LiamxZhang/CuBoats_Project/Arduino/Servo_Propeller_controller/readme.txt

1. 命令分类：推进器命令与舵机命令
2. 命令格式：开头为命令类型，中间部分为固定长度的命令值，结尾为命令截止符
3. 命令数据类型：bytes类型, positive 0~127
4. 推进器命令开头为\xff (-1)，中间为四个长度为1位的PWM值，依次赋予PWM1,2,3,4，总长度为6位，命令截止符为\xfa (-6)
5. PWM 40~140
6. 舵机命令的开头为\xfe (-2)，中间为四个长度为1位的命令，依次赋予舵机1,2,3,4，总长度位6位，命令截止符为\xfa (-6)
7. CMD 800~1550
8. 询问舵机状态命令的开头为\xfd (-3), 中间为四个长度为1位的命令， 只有数值为1~4的位置是指定舵机编号（非有效命令一般置0），命令截止符为\xfa (-6)
