LiamxZhang/CuBoats_Project/BillOfMaterials/Cuboat物料表.xlsx

Sheet: 工作表1
状态（待买/已买） | 物料类型 | 名称 | 电压电流功率 | 型号 | 数量 | 单价 | 总价 | 链接
 | 电子元器件 | 推进器 |  | 潜鲟F1 | 4 | ¥100.00 | ¥400.00 | 非淘宝购买
 | 电子元器件 | 电调 | 20A | 20A XT60+4mm香蕉头 | 4 | ¥65.93 | ¥263.72 | https://item.taobao.com/item.htm?spm=a1z09.2.0.0.54732e8dCYgAxd&id=614604326902&_u=12na70rva518
 | 电子元器件 | 可调磁铁 |  | FHT8100514 | 1 | ¥111.00 | ¥111.00 | https://item.taobao.com/item.htm?spm=a1z09.2.0.0.3ee52e8dYFiK1D&id=575461382916&_u=d1kec9s9b681
 | 电子元器件 | 5V舵机 | 5V | 20kg | 4 | ¥42.00 | ¥168.00 | https://detail.tmall.com/item.htm?id=599761402766&spm=a1z09.2.0.0.54732e8dCYgAxd&_u=12na70rv4cc1
 | 电子元器件 | 分电版 |  |  | 1 | ¥16.00 | ¥16.00 | https://item.taobao.com/item.htm?id=565032039200&ns=1&abbucket=2 (https://item.taobao.com/item.htm?spm=a230r.1.14.1.7c7926ebyYhPFB&id=565032039200&ns=1&abbucket=2)
 | 电子元器件 | 防水开关 |  |  | 1 | ¥18.23 | ¥18.23 | https://detail.tmall.com/item.htm?id=610787555747&spm=a1z09.2.0.0.57b92e8dkOdNFi&_u=r2na70rv882b
 | 电子元器件 | USB航插 |  | LP24 | 2 | ¥22.40 | ¥44.80 | https://detail.tmall.com/item.htm?id=586487585382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
 | 电子元器件 | HDMI航插 |  | LP-24 | 1 | ¥20.00 | ¥20.00 | https://detail.tmall.com/item.htm?id=606672940655&spm=a1z09.2.0.0.54732e8dCYgAxd&_u=12na70rvbd1a
 | 电子元器件 | USB 公对公线 |  |  | 3 | ¥4.80 | ¥14.40
 | 电子元器件 | HY2.0 线 |  | 4P公头 | 4 | ¥2.80 | ¥11.20 | https://item.taobao.com/item.htm?spm=a1z09.2.0.0.54732e8dCYgAxd&id=620576361942&_u=12na70rv6da6
 | 电子元器件 | type-c 数据线 |  |  |  | ¥3.60 | ¥0.00 | https://detail.tmall.com/item.htm?id=641692440106&ns=1&abbucket=2&skuId=4860605056030
 | 电子元器件 | microHDMI转HDMI |  |  | 1 | ¥34.00 | ¥34.00 | https://item.taobao.com/item.htm?id=682178905670&ns=1&abbucket=2 (https://item.taobao.com/item.htm?spm=a230r.1.14.36.6a8b3341Nln6Pm&id=682178905670&ns=1&abbucket=2)
 | 电子元器件 | S3平衡充母头 四线 |  |  | 12 | ¥1.30 | ¥15.60 | https://item.taobao.com/item.htm?id=572746769514&ali_trackid=1_f88e079ba19244c58fcefb4ea12fe2a7
 | 电子元器件 | S3平衡充母头 二线 |  |  | 8 | ¥0.80 | ¥6.40 | https://item.taobao.com/item.htm?id=572746769514&ali_trackid=1_f88e079ba19244c58fcefb4ea12fe2a7
 | 电子元器件 | XT-60公头 |  |  | 1 | ¥1.60 | ¥1.60 | https://item.taobao.com/item.htm?id=606959435821&ali_trackid=1_cd195052df1da4b5c81427232788b5fe
 | 电子元器件 | XT-60母头 |  |  | 1 | ¥1.60 | ¥1.60 | https://item.taobao.com/item.htm?id=606959435821&ali_trackid=1_cd195052df1da4b5c81427232788b5fe
 |  |  |  |  |  |  | ¥0.00
 | 标准件 | 扁头螺钉 |  | M4*10 | 8 | 0.625 | ¥5.00 | https://detail.tmall.com/item.htm?id=635221717233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
 | 标准件 | 圆头螺钉 |  | M4*10 | 16 | ¥0.24 | ¥3.84 | https://detail.tmall.com/item.htm?id=587776166655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
 | 标准件 | 圆头螺钉 |  | M2*12 | 8 | ¥0.78 | ¥6.24 | https://detail.tmall.com/item.htm?id=587776166655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
 |  |  |  |  |  |  | ¥0.00
 | 非标件 | 3mm防水胶条 |  |  |  |  | ¥0.00 | 无需购买
 | 非标件 | 背胶魔术贴 |  |  | 2 | ¥11.00 | ¥22.00 | https://detail.tmall.com/item.htm?id=589577268817&ns=1&abbucket=2&skuId=4263822736674
 | 非标件 | 海绵单面胶 |  |  |  |  | ¥0.00 | 无需购买
 |  |  |  |  |  |  | ¥0.00
 | 非标件 | 船身 |  |  | 1 | ¥626.00 | ¥626.00
 | 非标件 | 舵机框 |  |  | 4 | ¥29.00 | ¥116.00
 | 非标件 | 顶盖 |  |  | 1 | ¥150.00 | ¥150.00
 | 非标件 | 顶盖亚克力 |  |  | 1 | ¥40.00 | ¥40.00
 |  |  |  |  |  |  | ¥2095.63

Sheet: 量产机BOM
状态（待买/已买） | 物料类型 | 名称 | 电压电流功率 | 型号 | 数量 | 单价 | 总价 | 链接
 |  | 锂电池 | 12V 10A | 9800mAh |  |  |  | https://item.taobao.com/item.htm?spm=a1z09.2.0.0.25b42e8dy1Vv5Z&id=651315530801&_u=j2na70rveeae
待买 | 电子元器件 | 电调 | 20A | 20A XT60+4mm香蕉头 | 4 | ¥65.93 | ¥263.72 | https://item.taobao.com/item.htm?spm=a1z09.2.0.0.54732e8dCYgAxd&id=614604326902&_u=12na70rva518
待买 | 电子元器件 | 可调磁铁 |  | FHT8100514 | 1 | ¥111.00 | ¥111.00 | https://item.taobao.com/item.htm?spm=a1z09.2.0.0.3ee52e8dYFiK1D&id=575461382916&_u=d1kec9s9b681
待买 | 电子元器件 | 5V舵机 | 5V |  | 4
 | 非标件 | 联轴器 |  | 6.35mm | 4 |  |  | https://item.taobao.com/item.htm?spm=a1z09.2.0.0.25b42e8dy1Vv5Z&id=554246764479&_u=j2na70rv3361
待买 | 电子元器件 | 分线板 |  |  | 1 |  |  | https://item.taobao.com/item.htm?spm=a1z09.2.0.0.67002e8dQcyXE0&id=523744973776&_u=i2na70rvcec1
待买 | 电子元器件 | 防水开关 |  |  | 1 | ¥18.23 | ¥18.23 | https://detail.tmall.com/item.htm?id=610787555747&spm=a1z09.2.0.0.57b92e8dkOdNFi&_u=r2na70rv882b
待买 | 电子元器件 | USB航插 |  | LP24 | 2 | ¥22.40 | ¥44.80 | https://detail.tmall.com/item.htm?id=586487585382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
待买 | 电子元器件 | HDMI航插 |  | LP-24 | 1 | ¥20.00 | ¥20.00 | https://detail.tmall.com/item.htm?id=606672940655&spm=a1z09.2.0.0.54732e8dCYgAxd&_u=12na70rvbd1a
待买 | 电子元器件 | 2针航插 |  | LP-24
待买 | 电子元器件 | USB 公对公线 |  |  | 1 |  | ¥0.00
 |  | 电源插头公头 |  | 5.5*2.1 | 1 |  |  | https://detail.tmall.com/item.htm?id=552604408708&_u=i2na70rvab7d&skuId=3731955568301
 |  | 电源插头母头 |  | 5.5*2.2 | 1
待买 | 电子元器件 | HY2.0 端子线 |  | 4P公头 | 1 |  |  | https://item.taobao.com/item.htm?spm=a1z09.2.0.0.54732e8dCYgAxd&id=620576361942&_u=12na70rv6da6
待买 | 电子元器件 | HY2.0 端子线 |  | 2P公头 | 4 |  |  | https://item.taobao.com/item.htm?spm=a1z09.2.0.0.54732e8dCYgAxd&id=620576361942&_u=12na70rv6da6 | 待买 | 电子元器件 | HY2.0 线 | 4P公头 | 4 | ¥2.80 | ¥11.20 | https://item.taobao.com/item.htm?spm=a1z09.2.0.0.54732e8dCYgAxd&id=620576361942&_u=12na70rv6da6
待买 | 电子元器件 | type-c 电源线 |  |  | 1 |  | ¥0.00
待买 | 电子元器件 | microHDMI转HDMI |  |  | 1
 | 电子元器件 | 4mm香蕉头 |  |  | 12 |  | ¥0.00
 | 电子元器件 | XT-60公头 |  |  | 1 |  | ¥0.00
 | 电子元器件 | XT-60母头 |  |  | 5 |  | ¥0.00
 |  | 长脚排母 |  | 8pin | 5 |  | ¥0.00
 |  | 长脚排母 |  | 10pin | 1
已买
已买
已买
 |  |  |  |  |  |  | ¥0.00
已买 | 非标件 | 船身 |  |  | 1 | ¥626.00 | ¥626.00
已买 | 非标件 | 舵机框 |  |  | 4 | ¥29.00 | ¥116.00
已买 | 非标件 | 顶盖 |  |  | 1 | ¥150.00 | ¥150.00
已买 | 非标件 | 顶盖亚克力 |  |  | 1 | ¥40.00 | ¥40.00
 |  |  |  |  |  |  | ¥1389.75
