LiamxZhang/CuBoats_Project/BillOfMaterials/购买记录.xlsx

物料 | 数量 | 价格
电调 | 17 | 1052
香蕉头（公） | 55 | 112.5
舵机 | 16 | 672
xt60 （公） | 24 | 38.4
xt60 （母） | 24 | 38.4
开关 | 4 | 68.7
推进器 | 10 | 1035.72
HDMI口 | 4 | 83.2
USB口 | 4 | 0
USBbuffer | 5 | 49.8
电池 | 4 | 473
磁铁 | 16 | 1776
USB转USB | 4 | 39.6
arduino+蓝线 | 4 | 319
螺丝 | 若干 | 12.24
魔术贴 | 2 | 22
HDMI转micro | 4 | 66.64
typec | 5 | 11
分电板 | 7 | 131
联轴器 | 20 | 59
打印3 | 12 | 75
打印12 | 1 | 665.89
树莓派 | 4 | 0
亚克力板 | 5 | 0
排线 | 20 | 9.83
2心充电器 | 4 | 202
打印12 | 1 | 886.78
sd卡 | 4 | 163.6
打印12 | 2 | 1657.56
排母 | 若干 | 108.8
排线2 | 3 | 29.6
