LiamxZhang/CuBoats_Project/Drawings/舵机组合.SLDASM

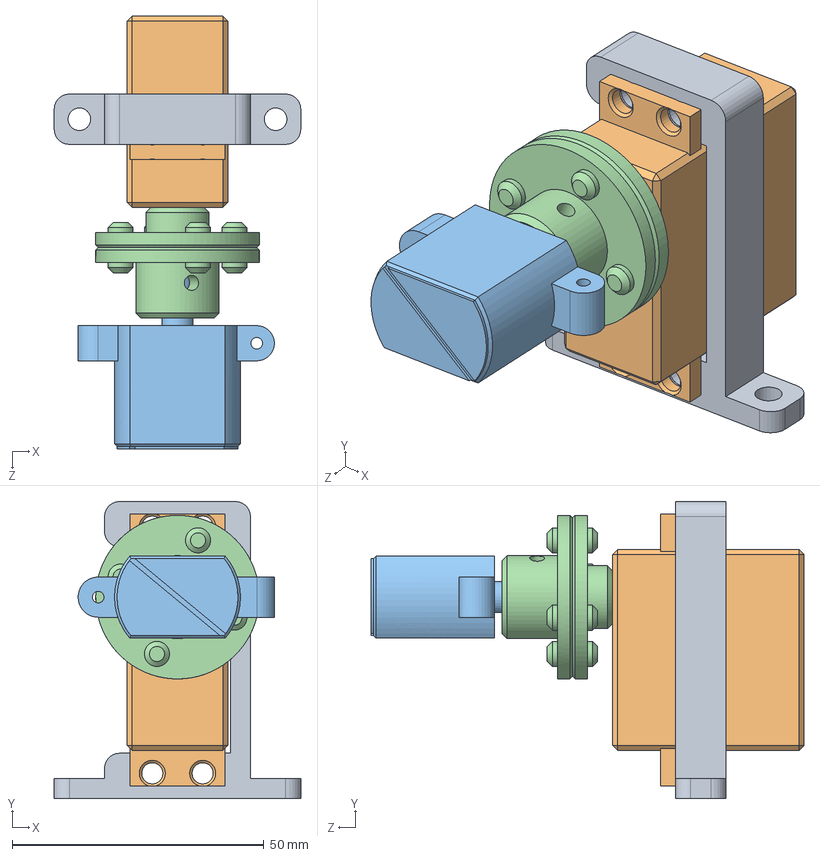
[picture p1: CAD file, 2022-10-27]
Drawings/舵机组合.SLDASM
49.0 x 59.0 x 86.0 mm
舵机连接件
35kg舵机
magswitch
舵盘联轴器
