LiamxZhang/CuBoats_Project/Drawings/充电航插.SLDPRT

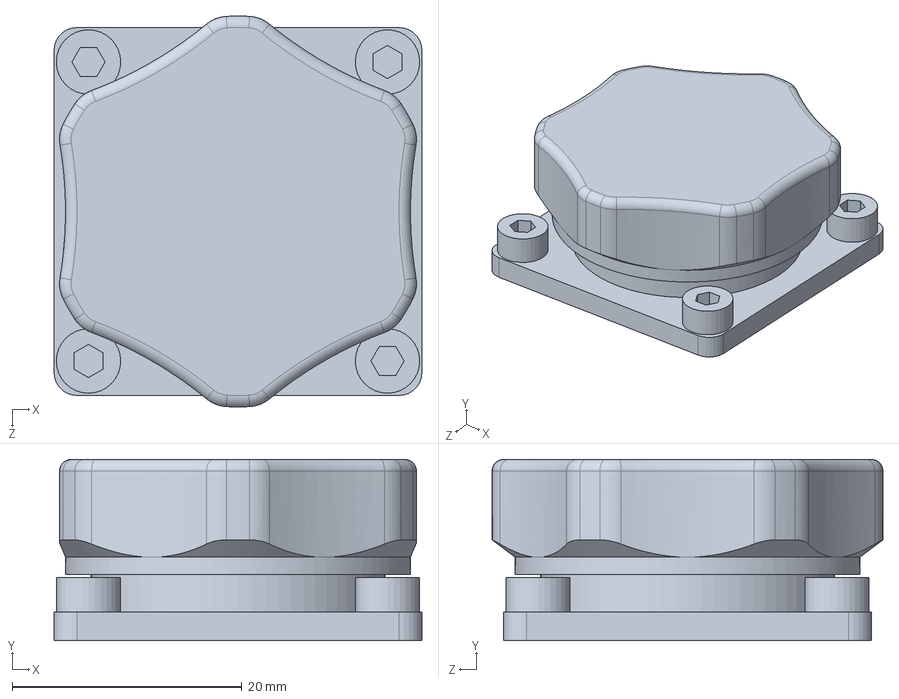
[picture p2: CAD file, 2022-10-27]
Drawings/充电航插.SLDPRT
32.0 x 15.8 x 34.0 mm
