LiamxZhang/CuBoats_Project/Drawings/电子设备/Grove-mega-shield.SLDPRT

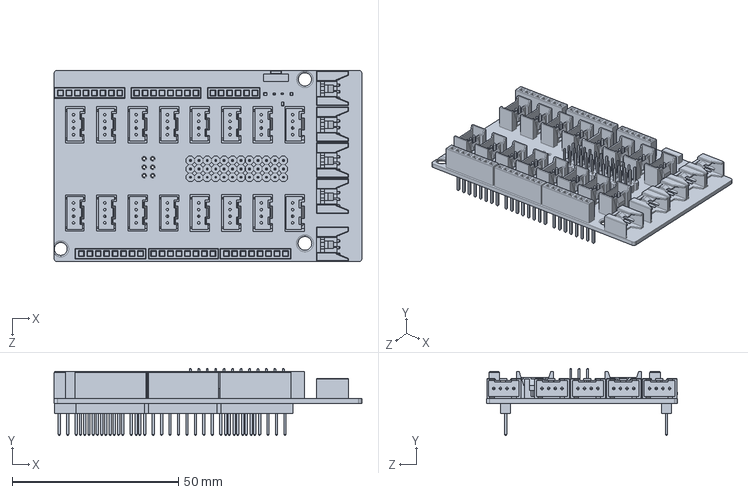
[picture p3: CAD file, 2022-10-27]
Drawings/电子设备/Grove-mega-shield.SLDPRT
92.5 x 20.2 x 57.5 mm
