LiamxZhang/CuBoats_Project/Drawings/船壳设计/12v锂电新.SLDPRT

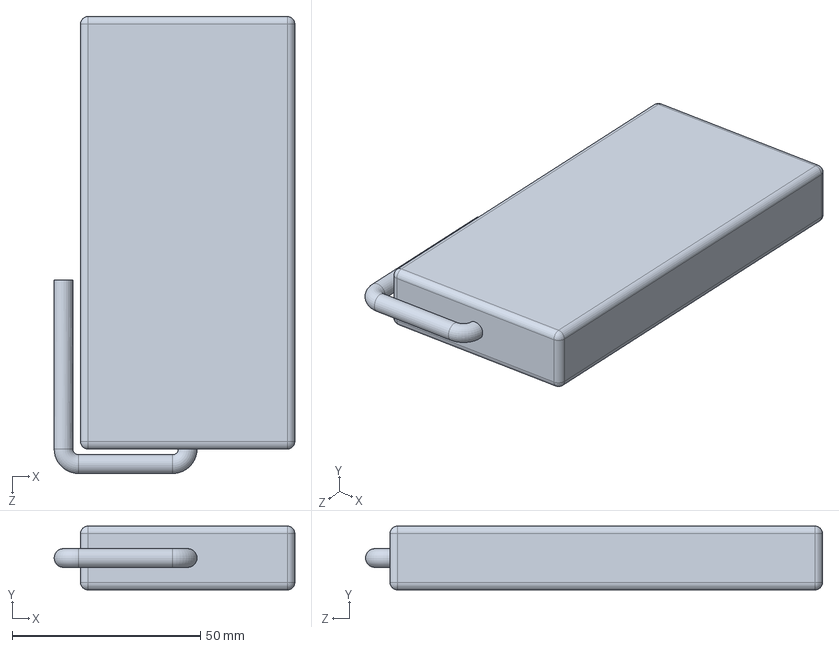
[picture p4: CAD file, 2022-10-27]
Drawings/船壳设计/12v锂电新.SLDPRT
64.0 x 17.0 x 121.5 mm
