LiamxZhang/CuBoats_Project/Drawings/配图/舵盘联轴器.SLDPRT

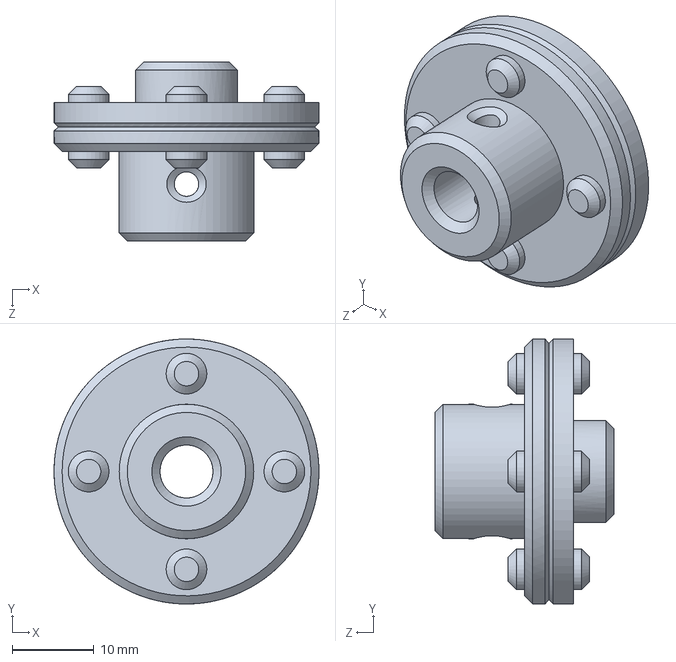
[picture p5: CAD file, 2022-10-27]
Drawings/配图/舵盘联轴器.SLDPRT
32.5 x 32.5 x 22.0 mm
