LiamxZhang/CuBoats_Project/Drawings/一体船体v2.SLDPRT

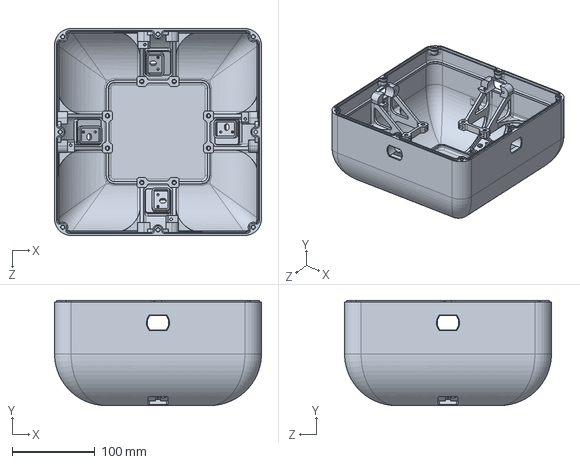
[picture p6: CAD file, 2022-10-27]
Drawings/一体船体v2.SLDPRT
250.0 x 127.0 x 250.0 mm
