LiamxZhang/CuBoats_Project/Drawings/船壳设计/推进器.SLDPRT

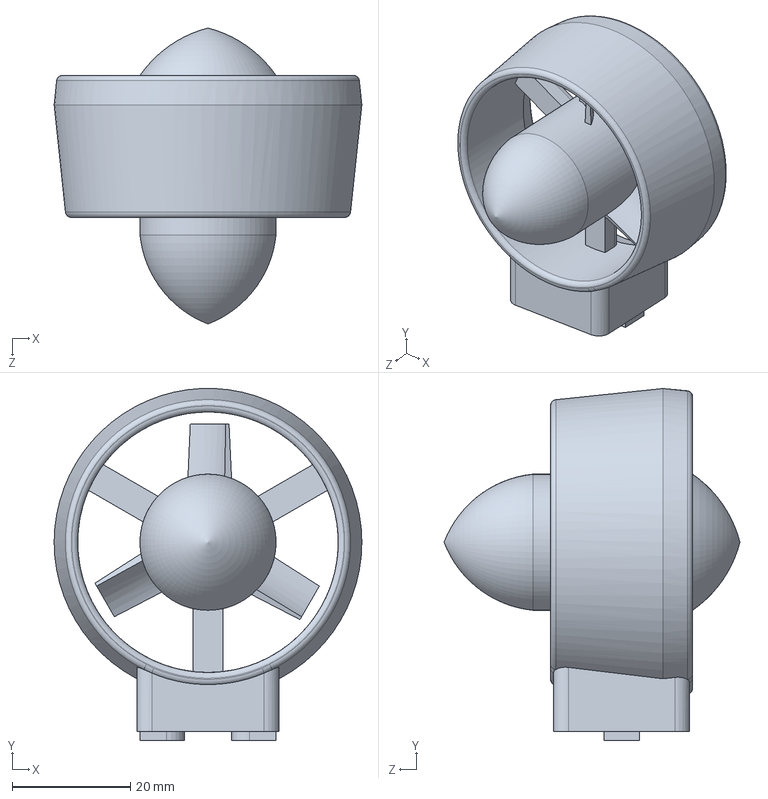
[picture p7: CAD file, 2022-10-27]
Drawings/船壳设计/推进器.SLDPRT
52.0 x 59.5 x 50.0 mm
