LiamxZhang/CuBoats_Project/Drawings/hdmi航插.SLDPRT

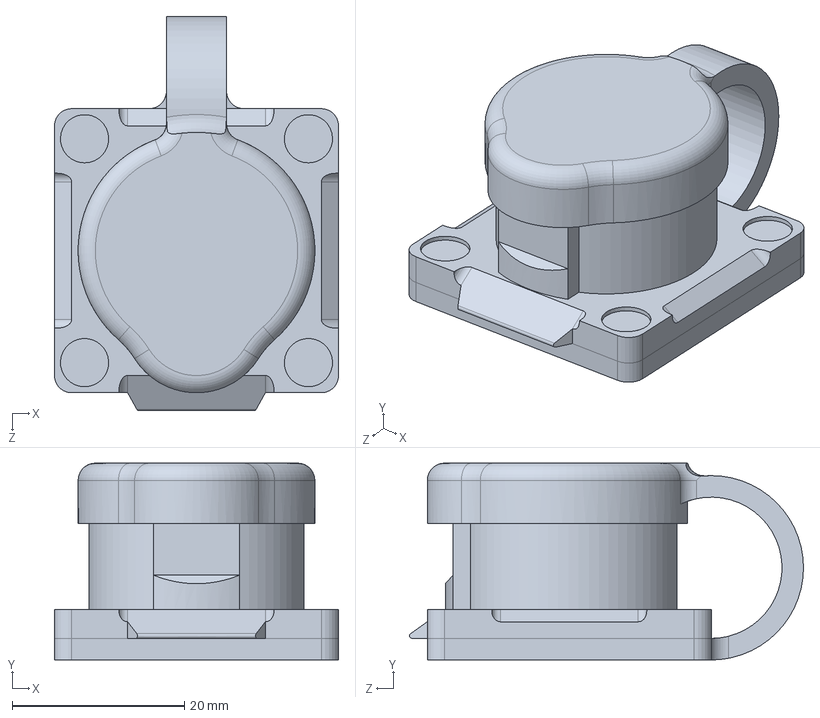
[picture p8: CAD file, 2022-10-27]
Drawings/hdmi航插.SLDPRT
33.0 x 22.9 x 45.8 mm
