LiamxZhang/CuBoats_Project/Drawings/船壳设计/35kg舵机.SLDPRT

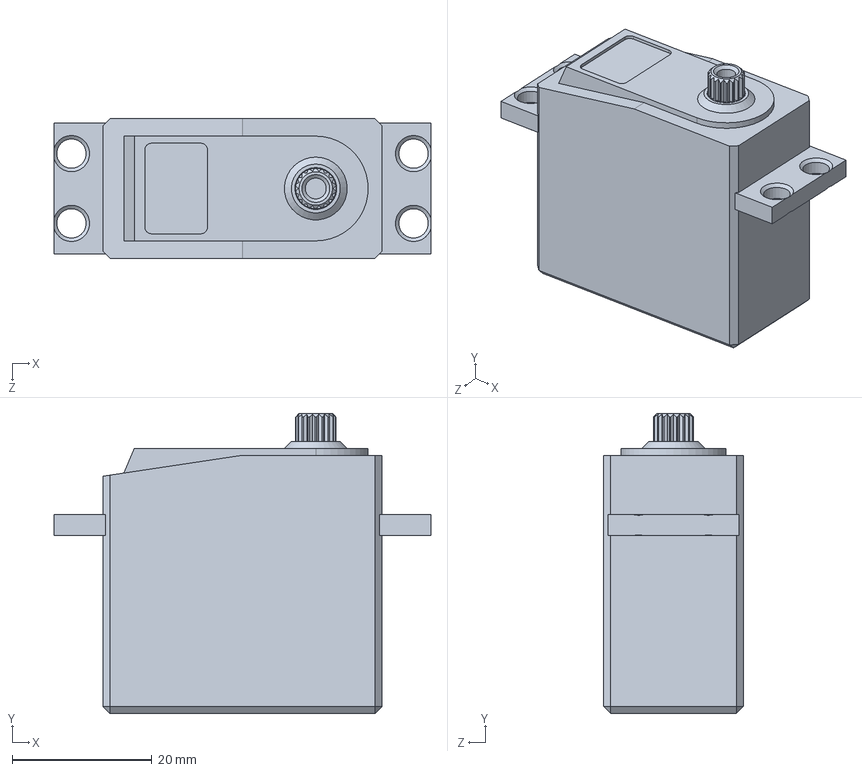
[picture p9: CAD file, 2022-10-27]
Drawings/船壳设计/35kg舵机.SLDPRT
54.0 x 43.0 x 20.0 mm
