LiamxZhang/CuBoats_Project/Drawings/亚克力顶盖.SLDPRT

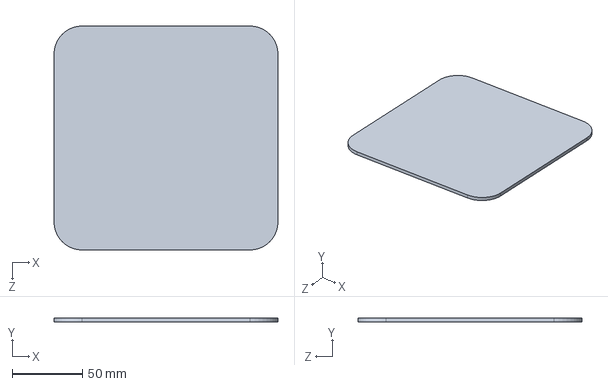
[picture p10: CAD file, 2022-10-27]
Drawings/亚克力顶盖.SLDPRT
159.5 x 3.00 x 159.5 mm
