LiamxZhang/CuBoats_Project/Drawings/船壳设计/magswitch.SLDPRT

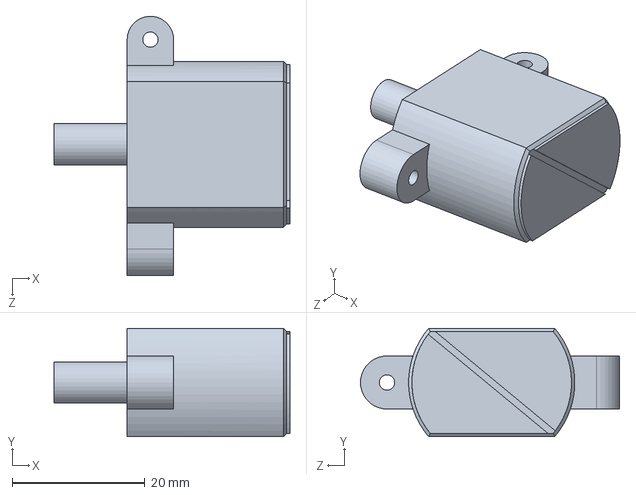
[picture p11: CAD file, 2022-10-27]
Drawings/船壳设计/magswitch.SLDPRT
35.5 x 16.3 x 39.0 mm
