LiamxZhang/CuBoats_Project/Drawings/舵机连接件.SLDPRT

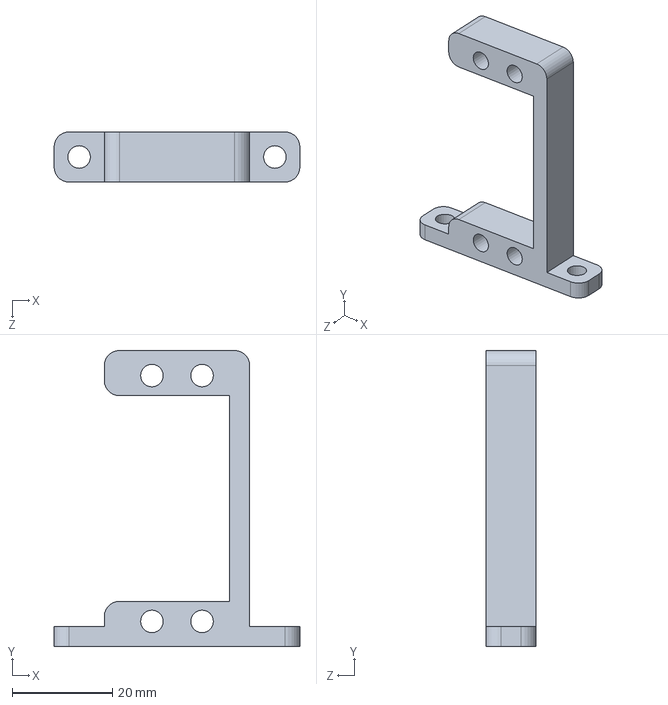
[picture p12: CAD file, 2022-10-27]
Drawings/舵机连接件.SLDPRT
49.0 x 59.0 x 10.0 mm
