LiamxZhang/CuBoats_Project/Drawings/船体顶盖.SLDPRT

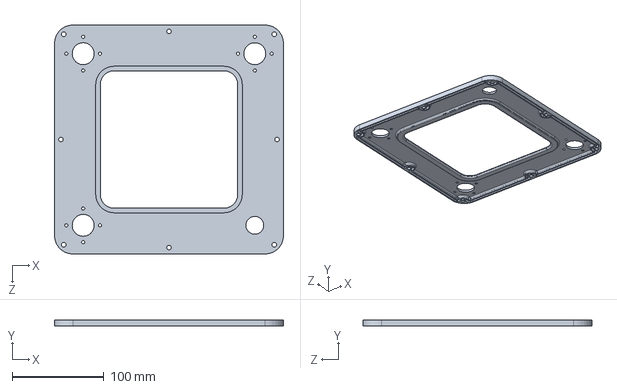
[picture p13: CAD file, 2022-10-27]
Drawings/船体顶盖.SLDPRT
250.0 x 7.00 x 250.0 mm
