LiamxZhang/CuBoats_Project/MainBoard-RaspberryPi/Sample_1/catkin_ws/src/pid_control_pkg/src/Configuration/MotionCaptureCalibration.csv

1.900153607130050659e-01
-5.434278964996337891e+00
1.566942473316709661e+00
