LiamxZhang/CuBoats_Project/MainBoard-RaspberryPi/Sample_2/catkin_ws/src/pid_control_pkg/src/Configuration/MotionCaptureCalibration.csv

-1.250767111778259277e-01
-5.264459133148193359e+00
3.099691647249042781e+00
