LiamxZhang/CuBoats_Project/MainBoard-RaspberryPi/Sample_3/catkin_ws/src/pid_control_pkg/src/Configuration/MotionCaptureCalibration.csv

-1.433058530092239380e-01
-5.277806282043457031e+00
3.124249319870465058e+00
