LiamxZhang/CuBoats_Project/MainBoard-RaspberryPi/Sample_4/catkin_ws/src/pid_control_pkg/src/Configuration/MotionCaptureCalibration.csv

-7.600276172161102295e-02
-5.318696975708007812e+00
1.478555992021834520e+00
