LiamxZhang/CuBoats_Project/MainBoard-RaspberryPi/Sample_1/catkin_ws/src/adrc_control_pkg/src/Configuration/MotionCaptureCalibration.csv

1.572928428649902344e-01
-5.310342788696289062e+00
6.342214330892727014e-01
