LiamxZhang/CuBoats_Project/(commit log)

2022-10-27 Create the project.
    [MotionCaptureCalibration.csv]
2022-10-27 Add the Solidworks files.
    [12v锂电新.SLDPRT, 35kg舵机.SLDPRT, Grove-mega-shield.SLDPRT, hdmi航插.SLDPRT, magswitch.SLDPRT, 一体船体v2.SLDPRT, 亚克力顶盖.SLDPRT, 充电航插.SLDPRT]
2022-10-27 Add the BOM files.
    [Cuboat物料表.xlsx, 购买记录.xlsx]
2022-11-03 Add the codes of cuboat 1 to 4.
    [MotionCaptureCalibration.csv]
